hkustenterprize/RM2025-Portable-Armor/Mechanics/Production/GFB_3mm_Armor-Front.DXF

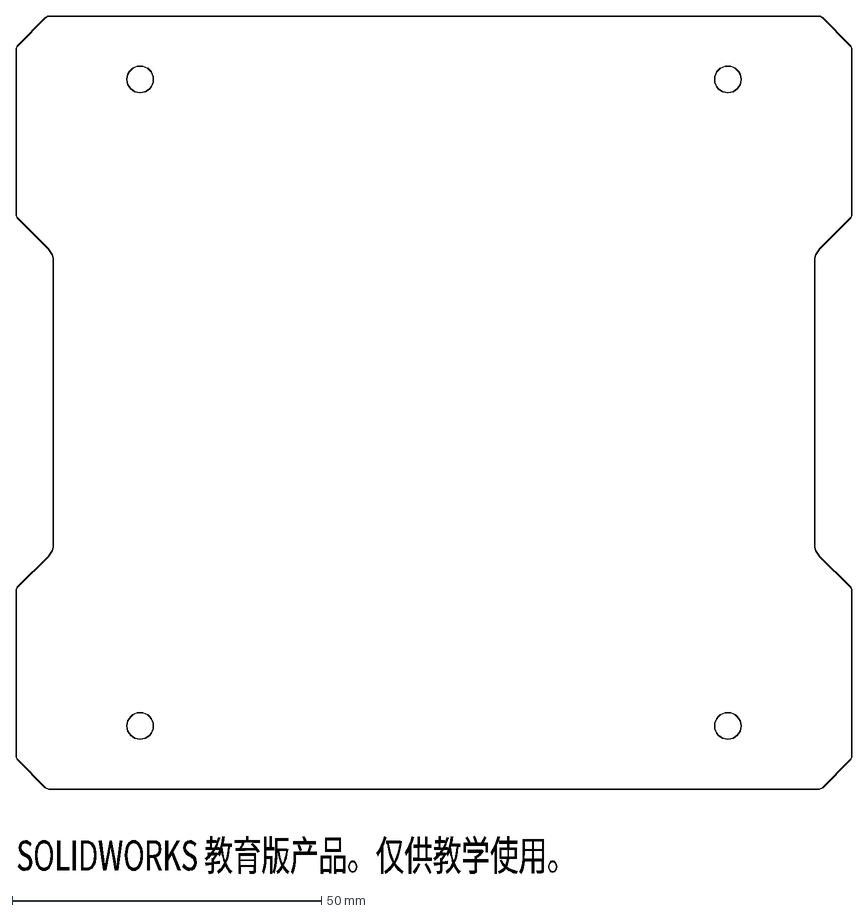
[picture p4: CAD file, 2025-08-17]
Mechanics/Production/GFB_3mm_Armor-Front.DXF
SOLIDWORKS 教育版产品。仅供教学使用。
