hkustenterprize/RM2025-Portable-Armor/Mechanics/灯罩.SLDPRT

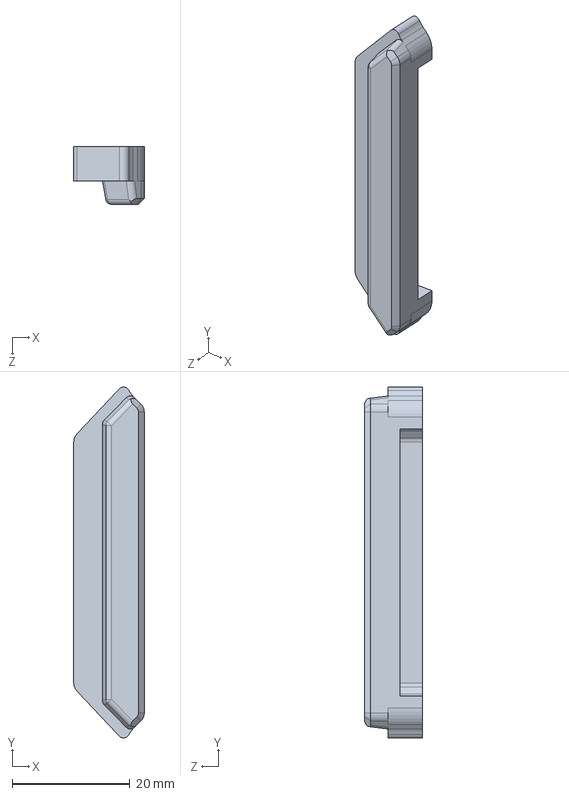
[picture p5: CAD file, 2025-08-17]
Mechanics/灯罩.SLDPRT
12.0 x 59.6 x 9.80 mm
