hkustenterprize/RM2025-Portable-Armor/Mechanics/PCB.SLDPRT

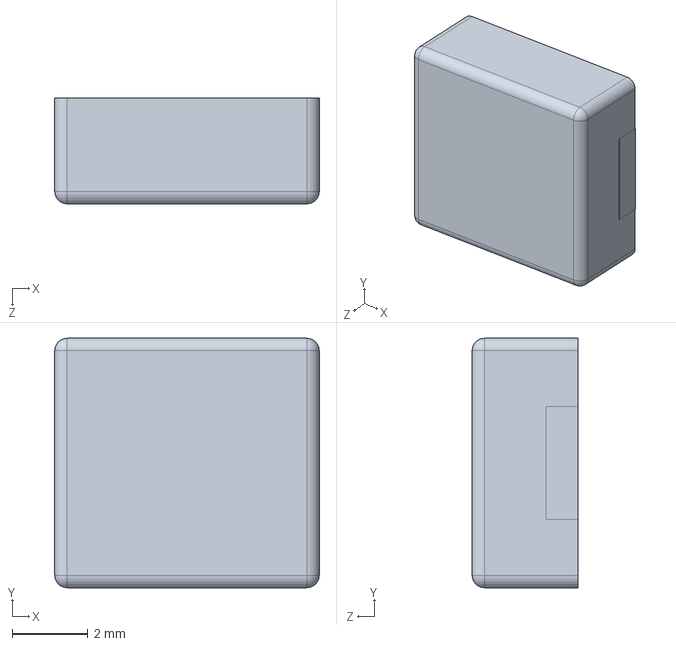
[picture p6: CAD file, 2025-08-17]
Mechanics/PCB.SLDPRT
7.01 x 6.60 x 2.80 mm
