hkustenterprize/RM2025-Portable-Armor/Mechanics/Production/3DP_PETG_BLACK_Protable-Armor-Body.STEP

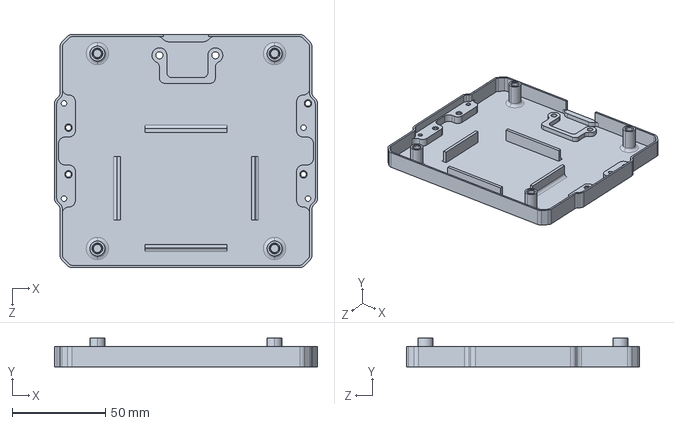
[picture p7: CAD file, 2025-08-17]
Mechanics/Production/3DP_PETG_BLACK_Protable-Armor-Body.STEP
141.0 x 15.5 x 125.0 mm
