hkustenterprize/RM2025-Portable-Armor/Mechanics/Body_3dp.SLDPRT

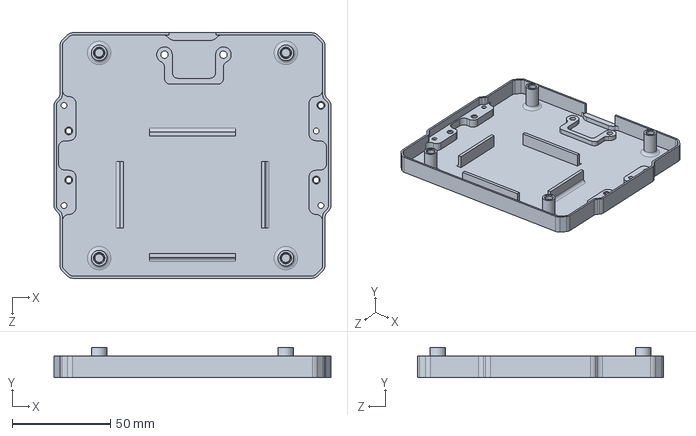
[picture p8: CAD file, 2025-08-17]
Mechanics/Body_3dp.SLDPRT
141.0 x 15.5 x 125.0 mm
