hkustenterprize/RM2025-Portable-Armor/Mechanics/玻纤盖板.SLDPRT

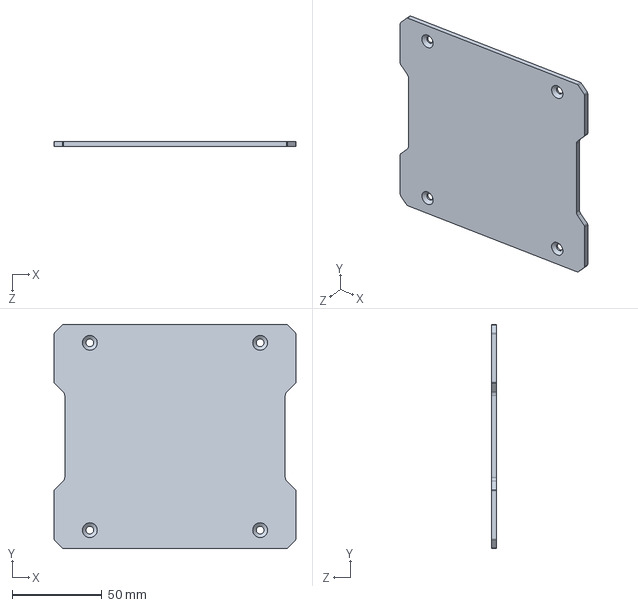
[picture p9: CAD file, 2025-08-17]
Mechanics/玻纤盖板.SLDPRT
135.0 x 125.0 x 3.00 mm
