hkustenterprize/RM2025-Portable-Armor/Mechanics/手持装甲板.SLDASM

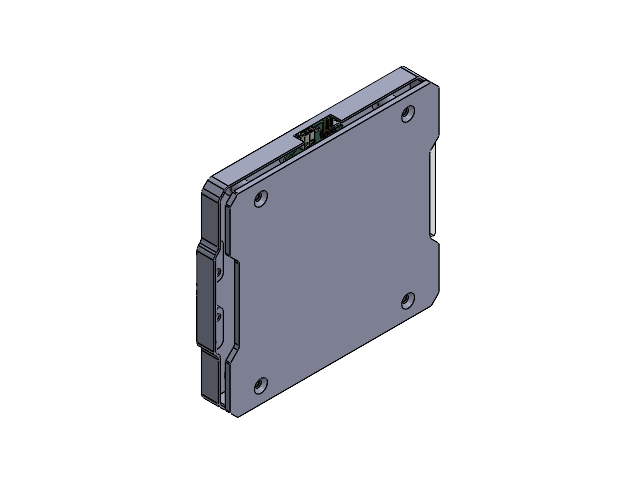
[picture p10: CAD file, 2025-08-17]
Mechanics/手持装甲板.SLDASM
玻纤盖板
Body_3dp
R_0603_1608Metric-0.step x 6
USB_C_Receptacle_16P_TopMnt_Horizontal_GCT_USB4105-xx-A.step
PinHeader_1x03_P254mm_Horizontal.step
C_1206_3216Metric-1.step
LED_0603_1608Metric-2.step x 2
JST_SM04B_GHS_TB.step x 4
CQ assembly.step
Fuse_1206_3216Metric-3.step
D_SMA-4.step
C_0805_2012Metric-5.step x 7
C_0603_1608Metric-6.step
R_1206_3216Metric-7.step
ArmorPowerV2_PCB.step
零件2^手持装甲板
灯罩
