hkustenterprize/RM2025-Portable-Armor/(list of files, cad)

Other CAD files:
Mechanics/Production/3DP_PETG_WHITE_Protable-Armor-Light-Bar.STEP
