hkustenterprize/RM2025-Portable-Armor/Hardware/RM2025-Portable-Armor.pdf

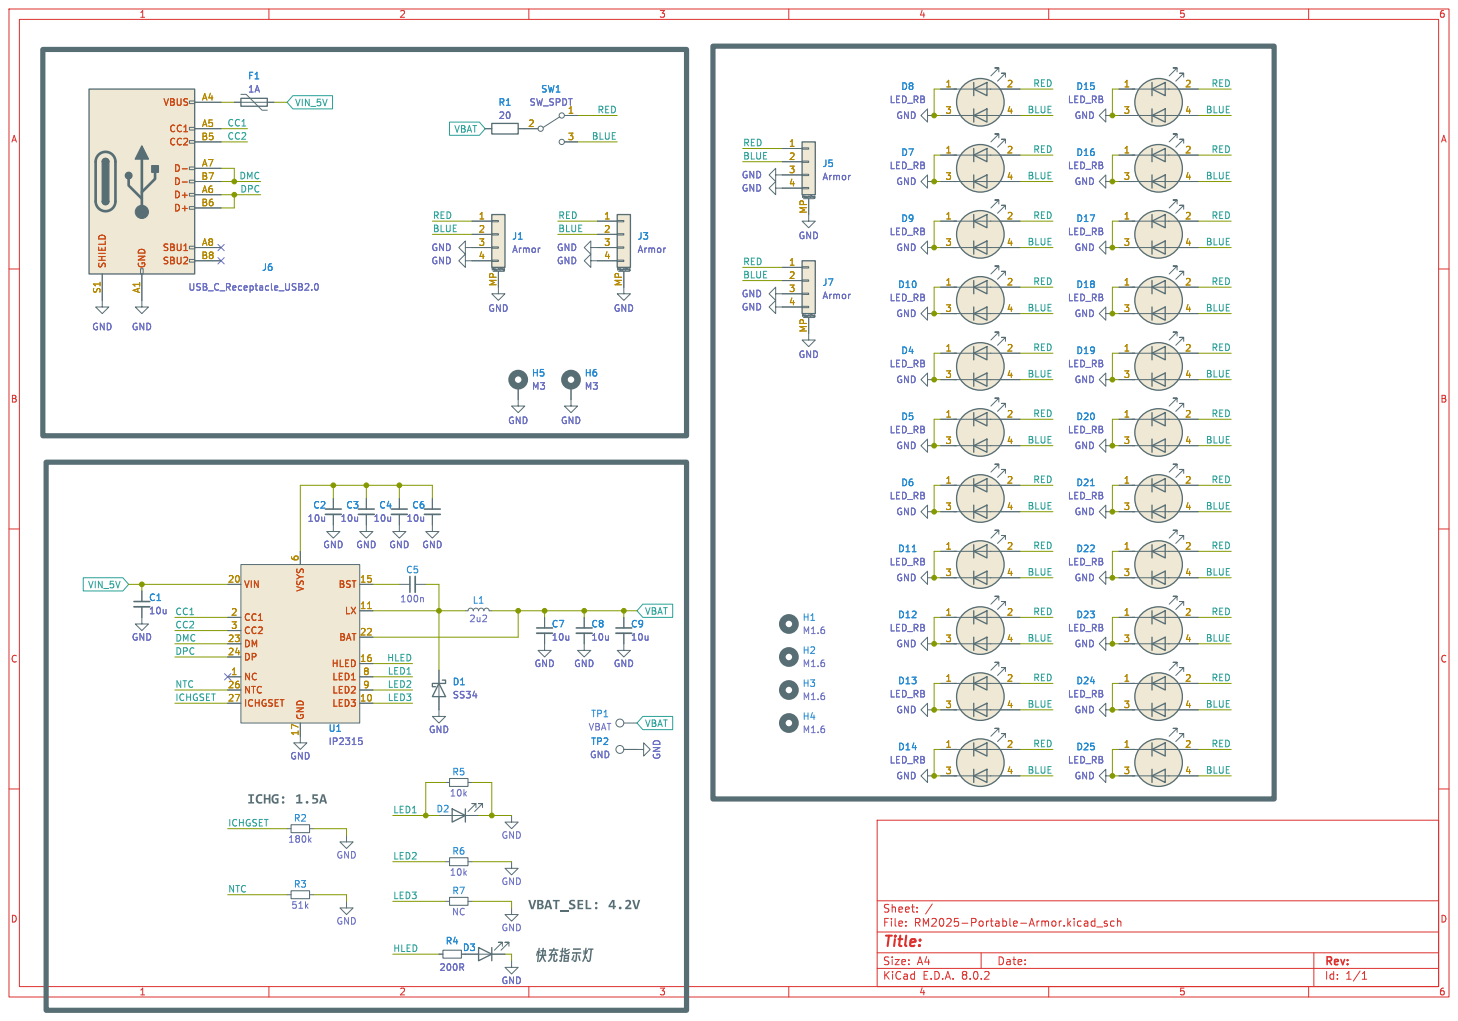
[picture p11: page 1]
